vitoriabezerranunes-lgtm/olho/hardware/iris_ambar.png

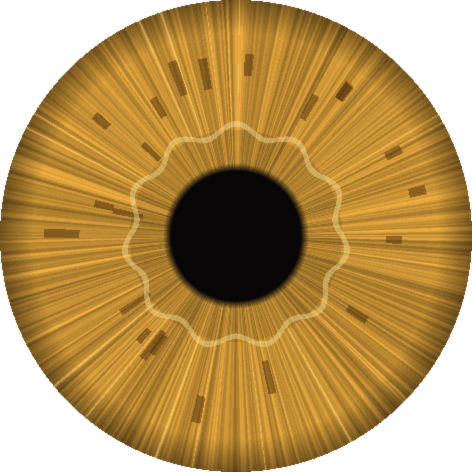
hardware/iris_ambar.png
