vitoriabezerranunes-lgtm/olho/hardware/iris_azul.png

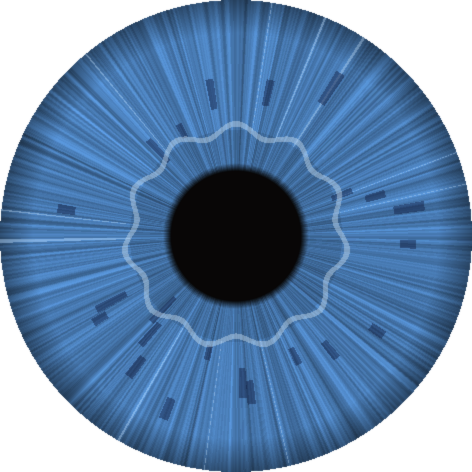
hardware/iris_azul.png
