vitoriabezerranunes-lgtm/olho/docs/iris_sheet.pdf

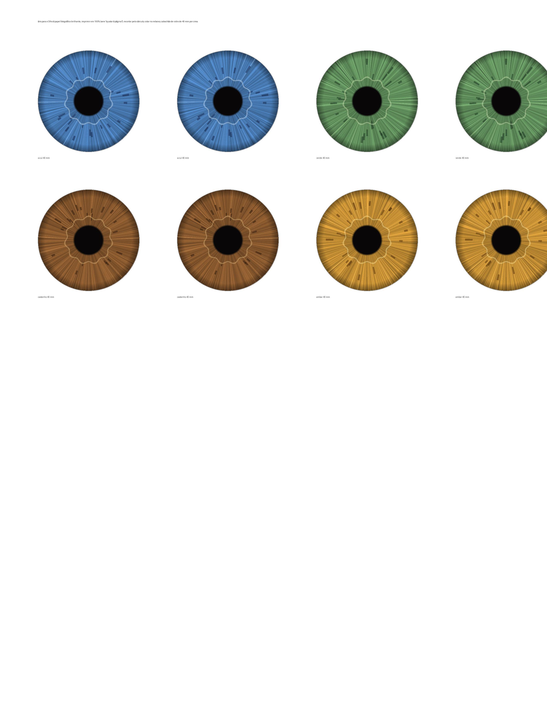
[picture p3: page 1]
