vitoriabezerranunes-lgtm/olho/hardware/iris_castanho.png

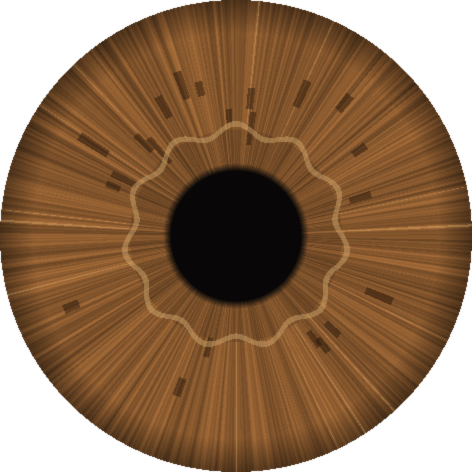
hardware/iris_castanho.png
