vitoriabezerranunes-lgtm/olho/hardware/iris_verde.png

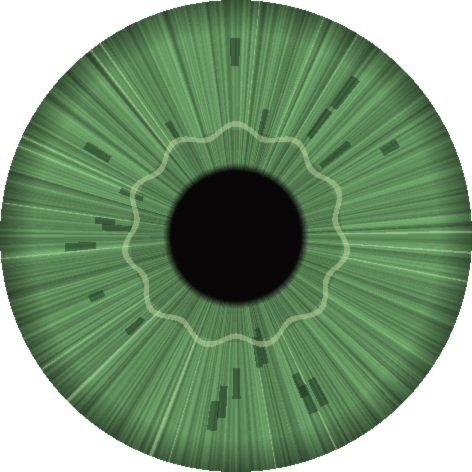
hardware/iris_verde.png
