vitoriabezerranunes-lgtm/olho/hardware/bin/phone_cradle.stl

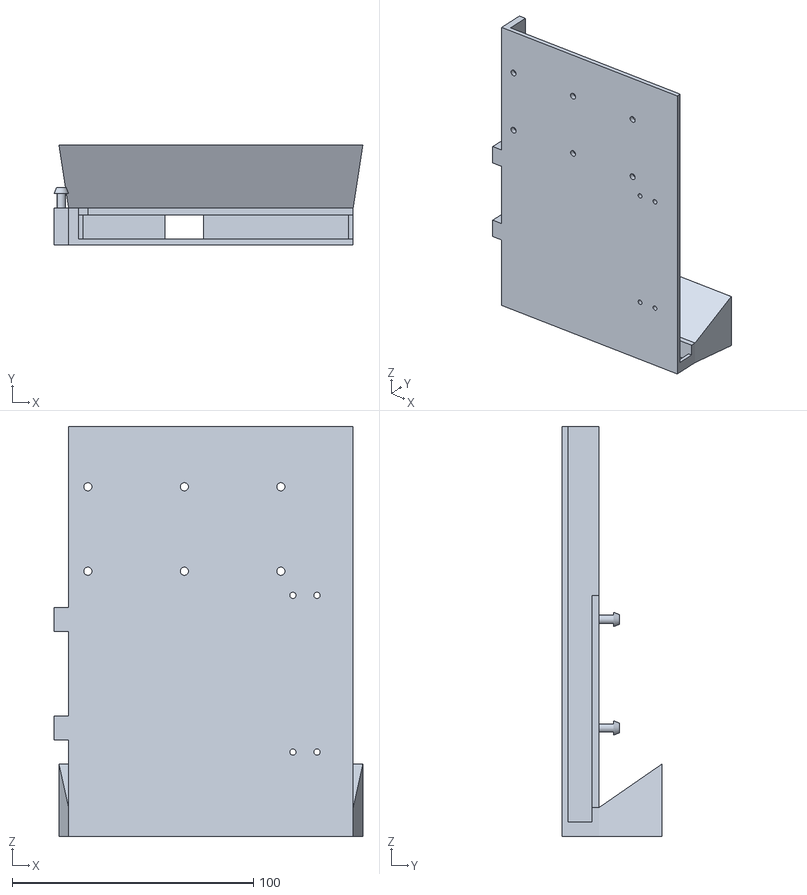
[picture p6: CAD file, 2026-10-30]
hardware/bin/phone_cradle.stl
128.0 x 41.3 x 170.0
