vitoriabezerranunes-lgtm/olho/hardware/body_argus_laurel.stl

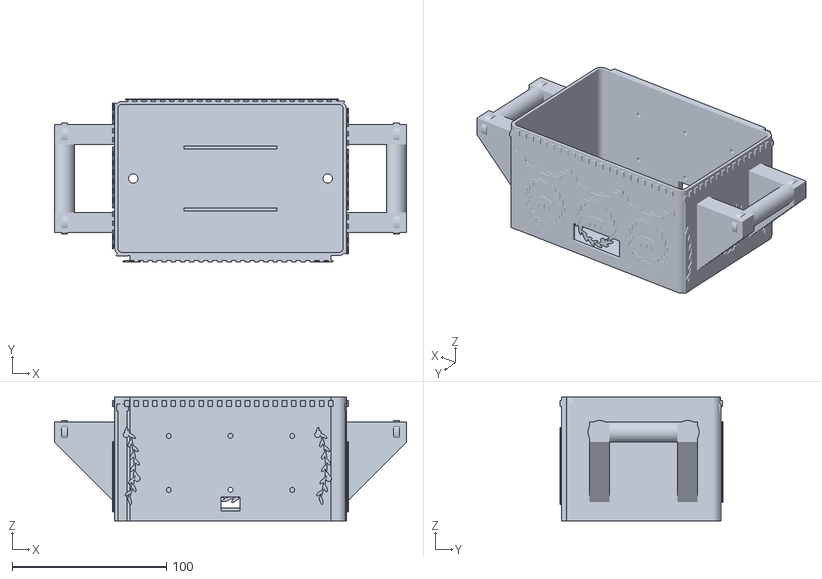
[picture p7: CAD file, 2026-10-30]
hardware/body_argus_laurel.stl
228.0 x 105.5 x 80.0
