vitoriabezerranunes-lgtm/olho/hardware/bin/lid_argus_laurel.stl

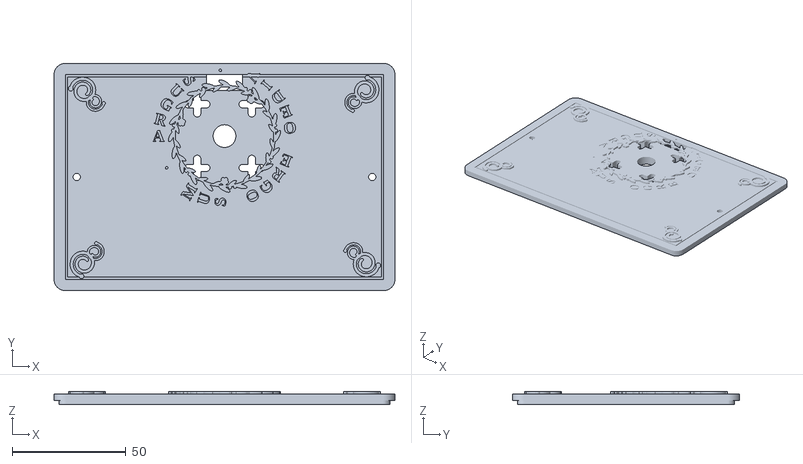
[picture p8: CAD file, 2026-10-30]
hardware/bin/lid_argus_laurel.stl
150.0 x 100.0 x 5.60
