vitoriabezerranunes-lgtm/olho/hardware/lid_argus_laurel.stl

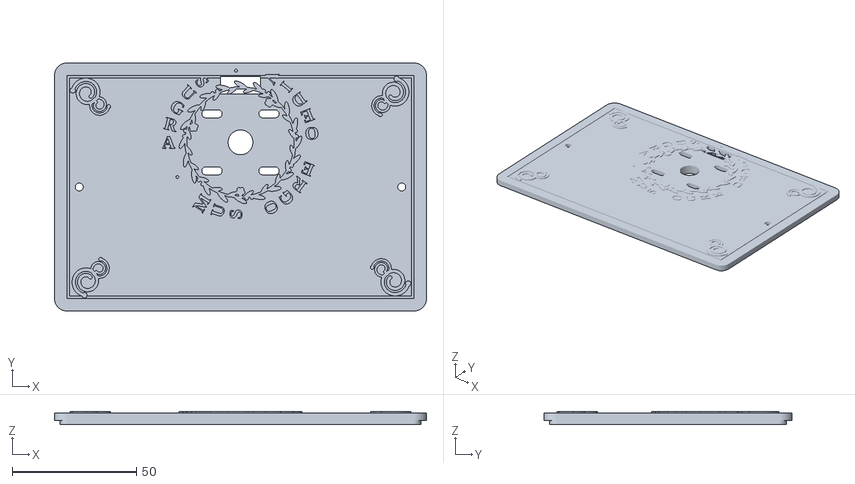
[picture p9: CAD file, 2026-10-30]
hardware/lid_argus_laurel.stl
150.0 x 100.0 x 5.30
