vitoriabezerranunes-lgtm/olho/hardware/bin/eye_front.stl

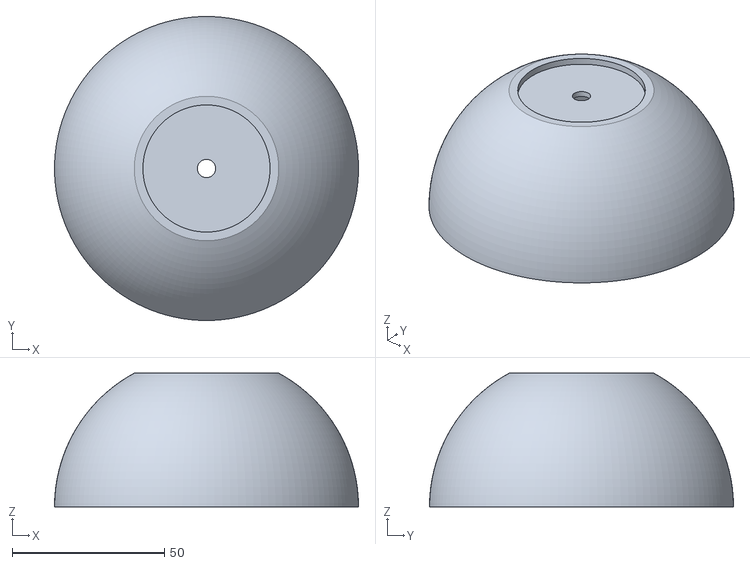
[picture p10: CAD file, 2026-10-30]
hardware/bin/eye_front.stl
100.0 x 100.0 x 44.0
