vitoriabezerranunes-lgtm/olho/hardware/body_argus_classic.stl

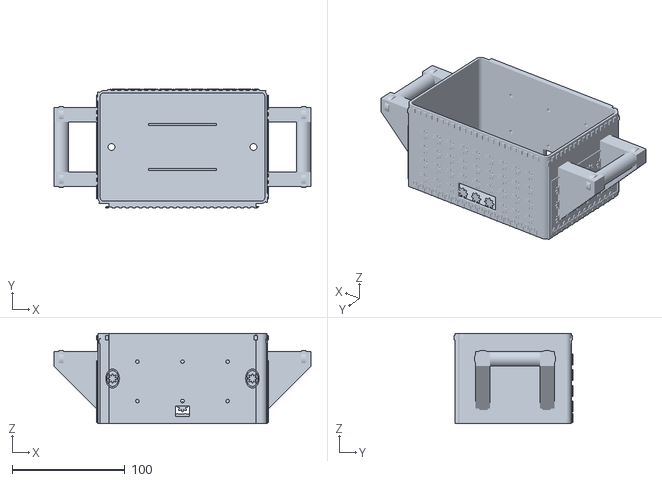
[picture p11: CAD file, 2026-10-30]
hardware/body_argus_classic.stl
228.0 x 105.4 x 80.0
