vitoriabezerranunes-lgtm/olho/hardware/bin/test_coupon.stl

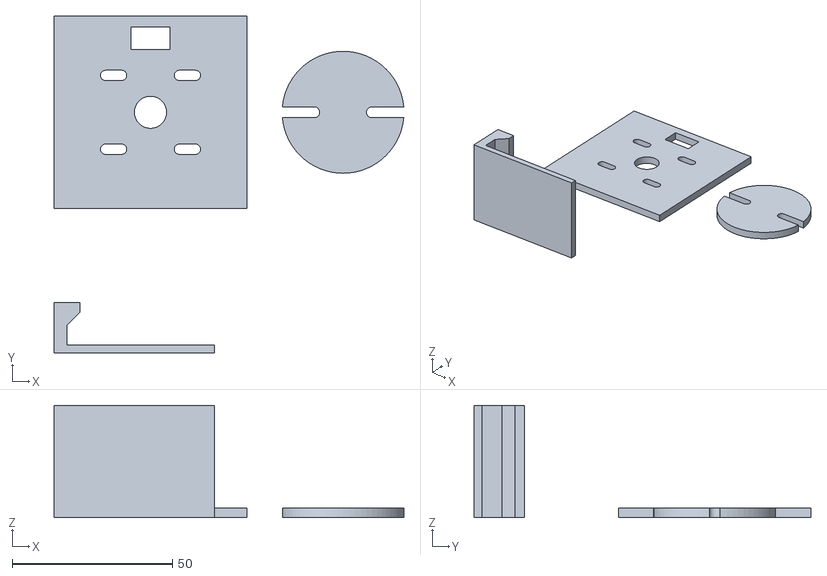
[picture p12: CAD file, 2026-10-30]
hardware/bin/test_coupon.stl
108.9 x 105.0 x 35.0
