vitoriabezerranunes-lgtm/olho/hardware/bin/body_argus_laurel.stl

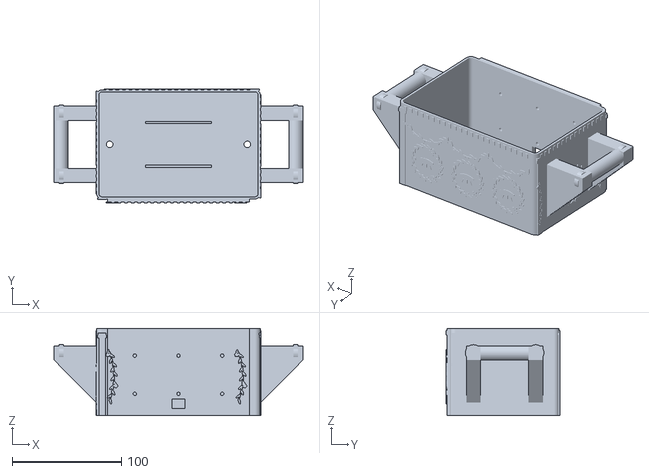
[picture p13: CAD file, 2026-10-30]
hardware/bin/body_argus_laurel.stl
228.0 x 104.4 x 80.0
