vitoriabezerranunes-lgtm/olho/hardware/bin/phone_rail.stl

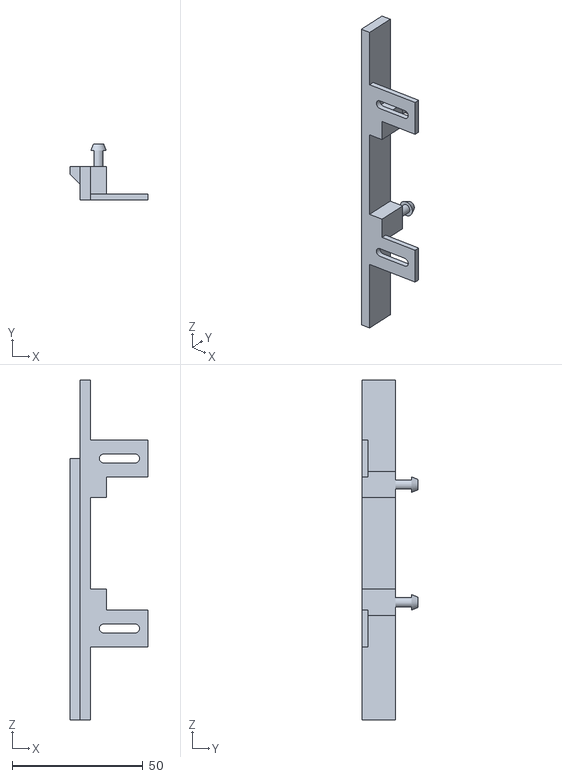
[picture p14: CAD file, 2026-10-30]
hardware/bin/phone_rail.stl
30.0 x 21.3 x 130.0
