vitoriabezerranunes-lgtm/olho/hardware/lid_argus_gothic.stl

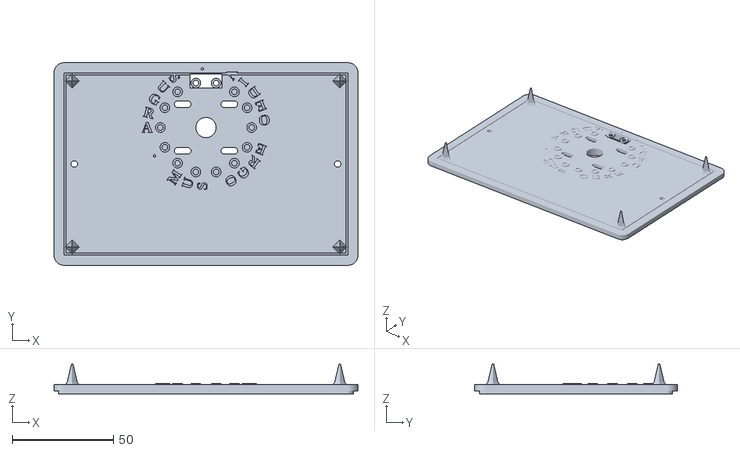
[picture p15: CAD file, 2026-10-30]
hardware/lid_argus_gothic.stl
150.0 x 100.0 x 14.8
