vitoriabezerranunes-lgtm/olho/hardware/bin/phone_clip.stl

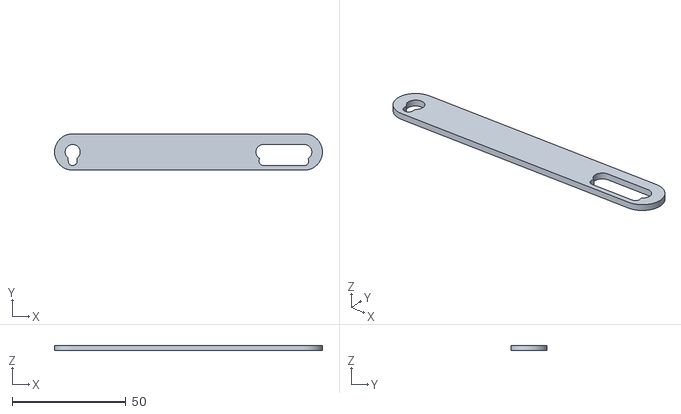
[picture p16: CAD file, 2026-10-30]
hardware/bin/phone_clip.stl
118.0 x 16.0 x 2.40
