vitoriabezerranunes-lgtm/olho/hardware/bin/eye_back.stl

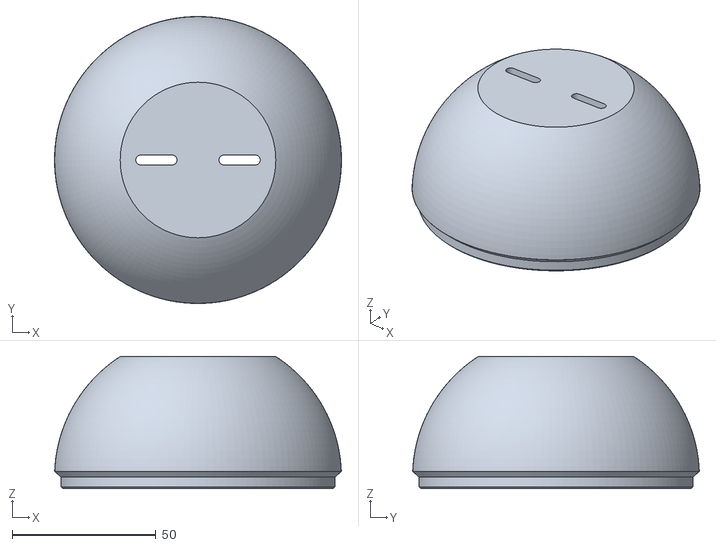
[picture p17: CAD file, 2026-10-30]
hardware/bin/eye_back.stl
100.0 x 100.0 x 46.0
