vitoriabezerranunes-lgtm/olho/hardware/lid_argus.stl

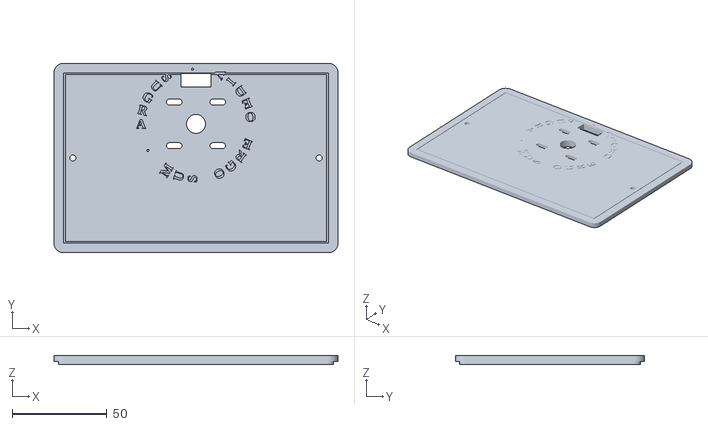
[picture p18: CAD file, 2026-10-30]
hardware/lid_argus.stl
150.0 x 100.0 x 4.60
