vitoriabezerranunes-lgtm/olho/hardware/eye_front.stl

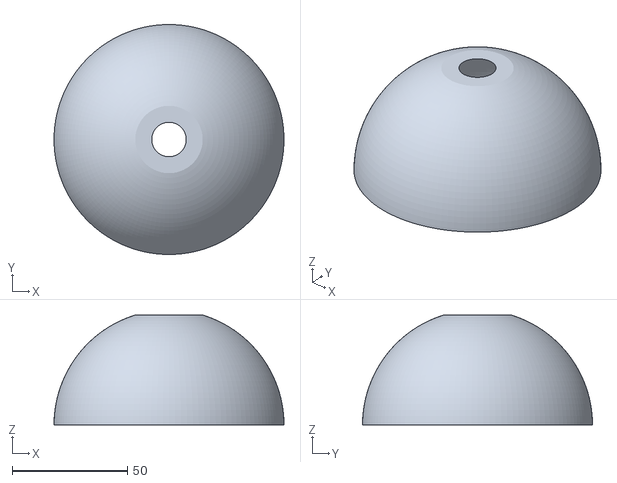
[picture p19: CAD file, 2026-10-30]
hardware/eye_front.stl
100.0 x 100.0 x 47.8
