vitoriabezerranunes-lgtm/olho/hardware/phone_cradle.stl

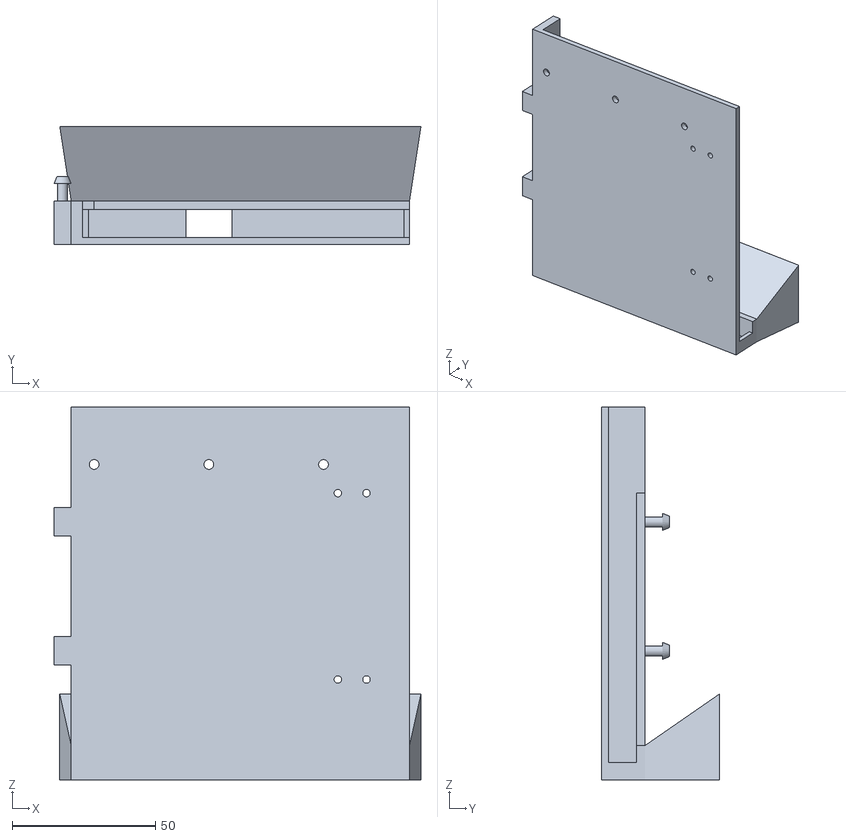
[picture p20: CAD file, 2026-10-30]
hardware/phone_cradle.stl
128.0 x 41.3 x 130.0
