vitoriabezerranunes-lgtm/olho/hardware/body.stl

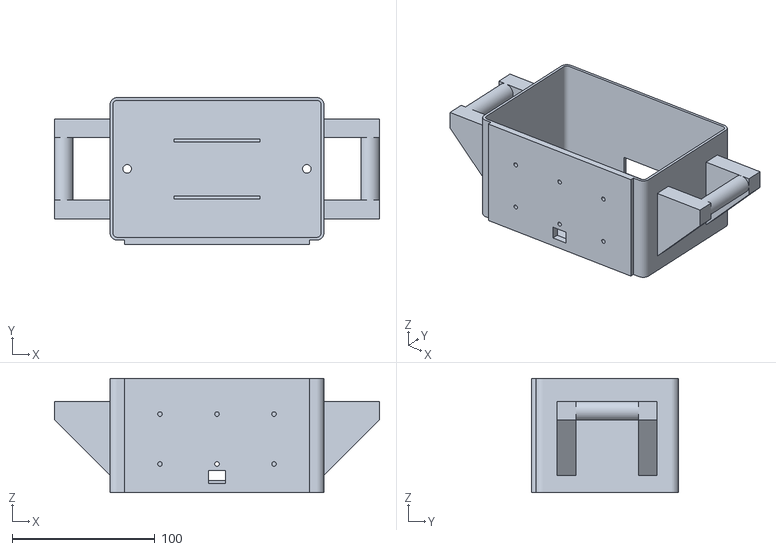
[picture p21: CAD file, 2026-10-30]
hardware/body.stl
228.0 x 103.0 x 80.0
