vitoriabezerranunes-lgtm/olho/hardware/iris.stl

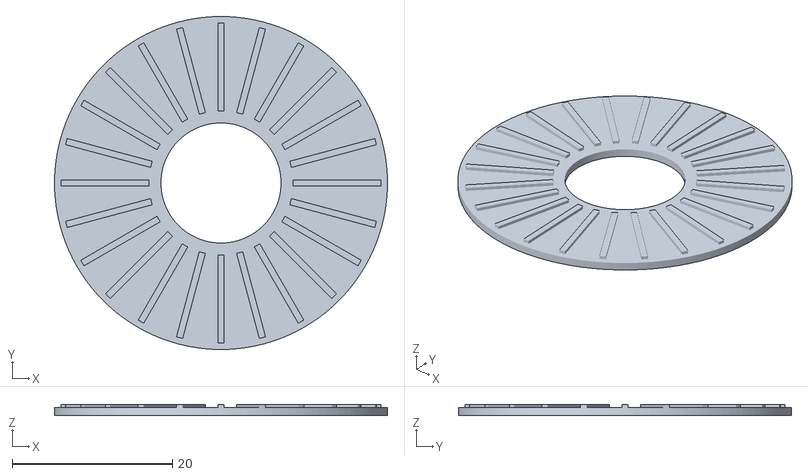
[picture p22: CAD file, 2026-10-30]
hardware/iris.stl
41.6 x 41.6 x 1.40
