vitoriabezerranunes-lgtm/olho/hardware/eye_mount.stl

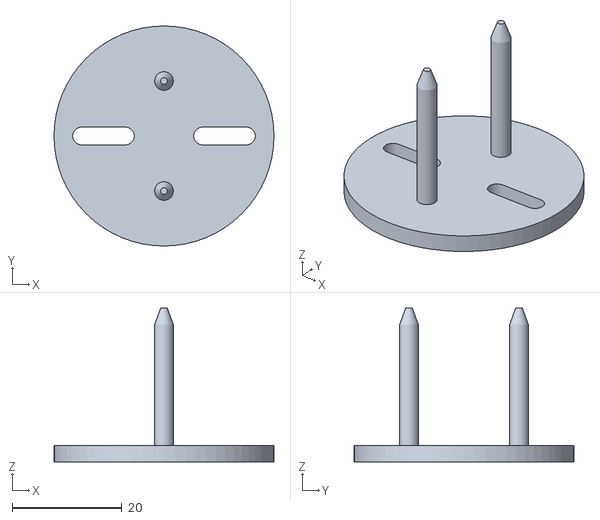
[picture p23: CAD file, 2026-10-30]
hardware/eye_mount.stl
40.0 x 40.0 x 28.0
