vitoriabezerranunes-lgtm/olho/hardware/phone_clip.scad

// TRAVA DO CELULAR: barrinha que encaixa por pressão nas cabeças dos 2 pinos do berço (mesma altura),
// passando por cima da traseira do celular. Imprime deitada. Precisa de 2 (uma por par de pinos: z=45 e z=90).
w_max = 88; rail = 4; slot_w = w_max;
peg_x = slot_w/2 + rail + 3;           // centro dos pinos (nas orelhas do berço)
span = 2*peg_x + 16;                   // sobra de 8 mm em cada ponta
t = 2.4; w = 16;
$fn = 48;
difference() {
  hull() { for (s=[-1,1]) translate([s*(span/2-w/2), 0, 0]) cylinder(d=w, h=t); }
  // furos de fechadura: entrada larga (passa a cabeça de 6 mm) + rasgo estreito (prende no pino de 3,5 mm)
  // esquerda: fechadura normal. direita: fechadura alongada 18 mm (o trilho móvel muda de lugar)
  translate([-peg_x, 0, -1]) cylinder(d=6.6, h=t+2);
  hull() { translate([-peg_x, 0, -1]) cylinder(d=3.9, h=t+2); translate([-peg_x, -4, -1]) cylinder(d=3.9, h=t+2); }
  hull() { translate([peg_x-18, 0, -1]) cylinder(d=6.6, h=t+2); translate([peg_x, 0, -1]) cylinder(d=6.6, h=t+2); }
  hull() { translate([peg_x-18, -4, -1]) cylinder(d=3.9, h=t+2); translate([peg_x, -4, -1]) cylinder(d=3.9, h=t+2); }
}
