vitoriabezerranunes-lgtm/olho/(list of files, cad)

Other CAD files:
hardware/lid_argus_classic.stl
hardware/body_argus_gothic.stl
hardware/body_argus.stl
hardware/eye_back.stl
hardware/test_coupon.stl
hardware/lid.stl
hardware/phone_clip.stl
hardware/phone_rail.stl
