vitoriabezerranunes-lgtm/olho/(commit log)

2026-10-29 v4/v7: parado por padrão; sensor ou celular, nunca os dois; vagar opcional
2026-10-30 Firmware v5: eco dos comandos recebidos e filtro de lixo
2026-10-30 v7/v8: rastreio suave com amortecimento; 16 Hz
2026-10-30 Firmware v10: corrige timeout do remoto (subtração sem sinal estourava)
    [olho_firmware.ino]
2026-10-30 Página v12: seletor de voz, tom e velocidade ajustáveis
2026-10-30 Página v15: Claude sem thinking, max_tokens 160, log de resposta vazia
2026-10-30 Página v17: campo de convidados (só local) alimenta o prompt; abertura pergunta o nome; histórico zera após 60 s sem rosto
2026-10-30 Página v18: exemplo de convidado pré-preenchido para teste
2026-10-30 Hardware: caixa, tampa, suporte do olho e berço do celular em OpenSCAD + STL
    [body.scad, body.stl, eye_mount.scad, eye_mount.stl, lid.scad, lid.stl, params.scad, phone_cradle.scad]
2026-10-30 Hardware: olho impresso em duas metades + íris
    [eye_back.scad, eye_back.stl, eye_front.scad, eye_front.stl, iris.scad, iris.stl]
2026-10-30 Corpo v2: alças laterais impressas; sem soquete de bastão
    [body.scad, body.stl]
2026-10-30 Corpo: furo frontal pro cabo de carga do celular
    [body.scad, body.stl]
2026-10-30 Berço v2: abas flexíveis + corneta acústica; sem fendas
    [phone_cradle.scad, phone_cradle.stl]
2026-10-30 Berço: pinos laterais pra elástico de cabelo
    [phone_cradle.scad, phone_cradle.stl]
2026-10-30 Tampa: pan-tilt recuado 18 mm; berço: 90 mm abaixo da caixa (celular não tapa o olho)
    [lid.scad, lid.stl, phone_cradle.scad, phone_cradle.stl]
2026-10-30 Trava do celular: barrinha que encaixa nos pinos do berço
    [phone_clip.scad, phone_clip.stl, phone_cradle.scad, phone_cradle.stl]
2026-10-30 Trava: barrinha mais larga, fechadura fechada
    [phone_clip.scad, phone_clip.stl]
2026-10-30 Trava: furos alinhados aos pinos, paredes fechadas
    [phone_clip.scad, phone_clip.stl]
2026-10-30 Berço: orelhas com pinos pra frente; trava alinhada
    [phone_clip.scad, phone_clip.stl, phone_cradle.scad, phone_cradle.stl]
2026-10-30 Berço v3: trilho direito ajustável com parafusos; trava com furo alongado
    [phone_clip.scad, phone_clip.stl, phone_cradle.scad, phone_cradle.stl, phone_rail.scad, phone_rail.stl]
2026-10-30 Olho: base plana 38 mm e rasgos longos pra fendas da placa; tampa: alívio do parafuso central
    [eye_back.scad, eye_back.stl, lid.scad, lid.stl]
2026-10-30 Medidas reais do pan-tilt (furos 23 mm, fendas ~30 mm): tampa e olho ajustados; peça de teste
    [eye_back.scad, eye_back.stl, lid.scad, lid.stl, test_coupon.scad, test_coupon.stl]
2026-10-30 Íris realistas em papel (4 cores) + rebaixo pra cabochão de vidro 40 mm
    [eye_front.scad, eye_front.stl]
2026-10-30 Olho frente: rebaixo 41,8 (vidro 40 ou íris impressa 41,6)
    [eye_front.scad, eye_front.stl]
2026-10-30 Decoração ARGUS: corpo e tampa com relevos, gravação em anel, olhos fechados, molduras; STLs decorados
    [body.scad, body_argus.stl, deco.scad, lid.scad, lid_argus.stl]
2026-10-30 Decoração gótica (Collegiate Gothic): arcada de lancetas com olhos, friso de quadrifólios, pináculos, contrafortes, soco; STLs
    [body_argus_gothic.stl, deco.scad, lid_argus_gothic.stl]
2026-10-30 Decoração clássica/barroca: rosetas, coroa de louros, volutas de acanto, dentículos, óvulos, pilastras, medalhões; STLs
    [body_argus_classic.stl, deco.scad, lid_argus_classic.stl]
2026-10-30 Decoração louros: coroas com olhos, ramos floridos, dentículos, pilastras; STLs
    [body_argus_laurel.stl, deco.scad, lid_argus_laurel.stl]
2026-10-30 Louros: ramos verticais corrigidos
    [body_argus_laurel.stl, deco.scad]
2026-10-30 Add louros STL zip to Pages for direct download
2026-10-30 Fix floating decoration (embed 0.3 mm), solid eye caps with 45° lip, remove rear slot; STL zip v2
    [body.scad, body_argus_laurel.stl, deco.scad, eye_back.scad, eye_back.stl, eye_front.scad, eye_front.stl, lid_argus_laurel.stl]
2026-10-30 Lid: cross-shaped pan-tilt slots for 23x27 base (measured 33x37); zip v3
    [lid.scad, lid_argus_laurel.stl]
2026-10-30 Lid: pan-tilt holes measured 27x31 c-c; zip v4
    [lid.scad, lid_argus_laurel.stl]
2026-10-30 Lid: cross slots centered 24x28 +-4 (edge-to-edge measured 24x28 => 21x25 c-c); zip v5
    [lid.scad, lid_argus_laurel.stl]
2026-10-30 Phone cradle: plate 170 mm tall so both rows of box holes exist (was 130, second row fell outside the part)
    [phone_cradle.scad, phone_cradle.stl]
2026-10-31 Page v25: English UI, new look (Cinzel/Spectral, gold hairlines), sarcastic persona, thinking off for speed, side-aware greetings, call-over and stare nudges, no re-greeting mid-conversation, hush bu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
2026-10-31 Page v27: EYEGO sees the costume (camera frame sent with greetings and first reply), sharper irony
2026-10-31 Page v28: caption screen shows LISTENING/THINKING/SPEAKING, live transcript, camera thumbnail with face box; continuous recognition with 0.9 s sentence debounce; black-tie rant
